fixdiaglab-design/esp32-obd-gauge/docs/hardware.md

# Апаратна частина

## Компоненти

| Компонент | Примітка |
|---|---|
| ESP32-C3 SuperMini | основна плата проєкту |
| Дисплей GC9A01 1.28" 240×240 | SPI, 7 пінів (VCC, GND, SCL, SDA, DC, CS, RST), без тачскріна й без виводу підсвітки |
| CAN-трансивер SN65HVD230 | 3.3 V. **Не** TJA1050/MCP2551: вони працюють від 5 V і не підходять до 3.3-вольтової логіки ESP32 |
| Штекер OBD-II з виводами | піни 4/5 (GND), 6 (CAN-H), 14 (CAN-L), 16 (+12 V) |
| MP1584EN | регульований понижувальний перетворювач, потрібен вихід 5.0 V |
| Запобіжник 1 А | у лінію +12 V |
| Макетна плата, дроти Dupont | |

## Розʼєм OBD-II

| Пін | Призначення |
|---|---|
| 4 | корпус (GND) |
| 5 | сигнальна земля (GND) |
| 6 | CAN-H |
| 14 | CAN-L |
| 16 | +12 V від акумулятора (постійне, навіть при вимкненому запалюванні). Для живлення приладу краще **не використовувати**, див. нижче |

## Живлення

Рекомендований варіант: **комутований +12 V через перехідник для запобіжника (fuse tap)**. Тоді з вимкненим запалюванням прилад не споживає нічого. На схемі [images/wiring.png](images/wiring.png) показано саме його.

1. **Налаштуйте buck до підключення плати.** Подайте на вхід 12 V, мультиметром на виході покрутіть підлаштовувальний резистор, поки не буде **5.0 V**. Лише потім зʼєднуйте вихід із пінами `5V` і `GND` ESP32-C3.
2. Візьміть **fuse tap** під ваш тип запобіжників і підключіть його до кола, яке вмикається із запалюванням і не є критичним для безпеки (не подушки, не ABS, не двигун). Яке саме, дивіться в схемі блоку запобіжників вашого авто. Запобіжник у перехіднику 1–2 А.
3. Мультиметром перевірте: без запалювання на цьому колі 0 V, із запалюванням близько 12 V.
4. +12 V від fuse tap подайте на вхід buck. **Пін 16 розʼєму OBD-II не підключайте**, інакше прилад живитиметься постійно в обхід запалювання.
5. GND беріть з піна 4 або 5 розʼєму OBD-II, CAN-H і CAN-L з пінів 6 і 14.
6. Поруч із входом buck рекомендовано поставити електролітичний конденсатор **470–1000 мкФ, 25 В**: при запуску двигуна напруга короткочасно просідає, і без нього плата може перезавантажитися.
7. **Під час прошивки через USB відключайте buck** від плати (щоб не було двох джерел живлення одночасно).

### Альтернатива: живлення від піна 16 OBD-II

Простіше, але прилад живиться завжди, навіть із вимкненим запалюванням. Лінія: пін 16 → запобіжник 1 А → вхід buck, GND з піна 4 або 5. Прилад споживає струм і на стоянці; підсвітка дисплея не вимикається навіть у режимі сну (у модуля з 7 пінами немає виводу керування підсвіткою). Споживання автор не вимірював. При тривалій стоянці відключайте прилад або додайте вимикач.

### Сон

Якщо авто не знайдено (немає відповіді на запити OBD) протягом `SLEEP_AFTER_MS` (за замовчуванням 15 хвилин), плата засинає в режимі deep sleep й прокидається, коли на CAN-шині з'являється трафік (лінія CRX, GPIO4). Кнопка BOOT (GPIO9) вивести плату зі сну не може: це обмеження ESP32-C3.

## Підключення

Дисплей GC9A01 (апаратний SPI):

| Дисплей | ESP32-C3 |
|---|---|
| SCL | GPIO6 |
| SDA | GPIO7 |
| CS | GPIO10 |
| DC | GPIO1 |
| RST | GPIO0 |
| VCC | 3V3 |
| GND | GND |

CAN-трансивер SN65HVD230:

| Трансивер | Куди |
|---|---|
| CTX | GPIO3 |
| CRX | GPIO4 |
| 3V3 | 3V3 |
| GND | GND |
| CANH | OBD-II пін 6 |
| CANL | OBD-II пін 14 |

Кнопка: вбудована кнопка **BOOT** (GPIO9). Не тримайте її натиснутою при подачі живлення: GPIO9 на ESP32-C3 вмикає режим завантаження.

Схема: [images/wiring.png](images/wiring.png).

> На платах із SN65HVD230 часто є запаяний резистор 120 Ом (термінатор). Шина авто вже має власні термінатори; вплив цього резистора в проєкті окремо не перевірявся.

## Варіант для ESP32 WROOM-32 DevKit

Якщо замість C3 використовується WROOM-32, змініть у скетчі визначення пінів:

| Сигнал | GPIO |
|---|---|
| TFT_SCK | 18 |
| TFT_MOSI | 23 |
| TFT_CS | 5 |
| TFT_DC | 16 |
| TFT_RST | 17 |
| CAN_TX | 22 |
| CAN_RX | 21 |
| BTN_PIN | 0 |

Живлення в цьому випадку подається на `VIN`, а не на `3V3`. Цей варіант в автора не перевірявся повністю на авто.

## CAN-шина

- Швидкість: 500 кбіт/с, а якщо авто не відповідає, 250 кбіт/с (перебір автоматичний).
- Адресація: 11-бітні ідентифікатори, запит `0x7DF`, відповіді `0x7E8–0x7EF`.
- Лише стандартні запити режиму 01. 29-бітні адреси й K-line не підтримуються.
