fixdiaglab-design/esp32-obd-gauge/firmware/assets/arc-segment-masks/arc_segments_27_240.png

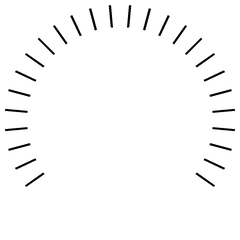
firmware/assets/arc-segment-masks/arc_segments_27_240.png
