fixdiaglab-design/esp32-obd-gauge/1,28TFT ESP32.stl

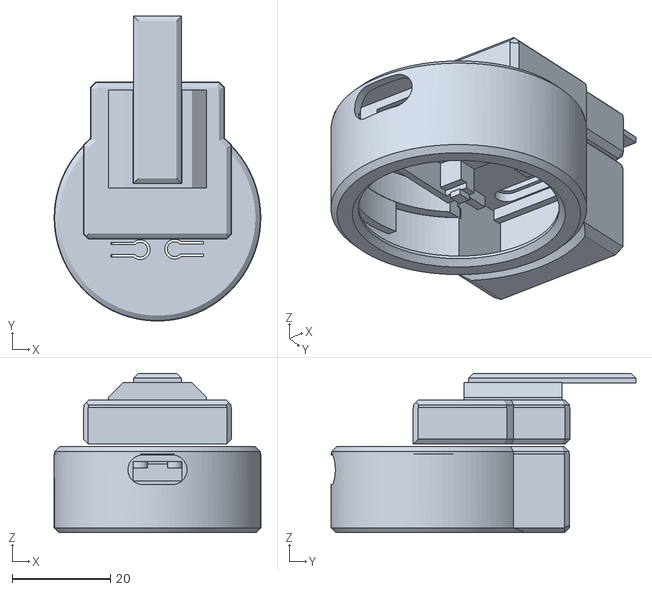
[picture p8: CAD file, 2026-10-26]
1,28TFT ESP32.stl
42.0 x 62.0 x 32.4
