fixdiaglab-design/esp32-obd-gauge/firmware/speedo_universalwifi/ui_font_Font1.c

/*******************************************************************************
 * Size: 26 px
 * Bpp: 1
 * Opts: --bpp 1 --size 26 --font D:/proect arduino/assets/RussoOne-Regular.ttf -o D:/proect arduino/assets\ui_font_Font1.c --format lvgl -r 0x20-0x7f --no-compress --no-prefilter
 ******************************************************************************/

#include "ui.h"

#ifndef UI_FONT_FONT1
#define UI_FONT_FONT1 1
#endif

#if UI_FONT_FONT1

/*-----------------
 *    BITMAPS
 *----------------*/

/*Store the image of the glyphs*/
static LV_ATTRIBUTE_LARGE_CONST const uint8_t glyph_bitmap[] = {
    /* U+0020 " " */
    0x0,

    /* U+0021 "!" */
    0xff, 0xff, 0xff, 0xff, 0xff, 0xff, 0xff, 0xf7,
    0x0, 0x1f, 0xff, 0xc0,

    /* U+0022 "\"" */
    0xf7, 0xfb, 0xfd, 0xfe, 0xff, 0x7f, 0xbc,

    /* U+0023 "#" */
    0x7, 0x8f, 0x1, 0xe3, 0xc0, 0x78, 0xf0, 0x1e,
    0x3c, 0x7f, 0xff, 0xdf, 0xff, 0xf7, 0xff, 0xfc,
    0x3c, 0x78, 0x1f, 0x1e, 0x7, 0x8f, 0x81, 0xe3,
    0xc3, 0xff, 0xfe, 0xff, 0xff, 0xbf, 0xff, 0xe3,
    0xc7, 0x80, 0xf1, 0xe0, 0x3c, 0x78, 0xf, 0x1e,
    0x0,

    /* U+0024 "$" */
    0x3, 0x80, 0x7, 0x0, 0xe, 0x1, 0xff, 0xc7,
    0xff, 0x9f, 0xff, 0x3e, 0x0, 0x7c, 0x0, 0xf8,
    0x1, 0xf0, 0x3, 0xff, 0xe3, 0xff, 0xe3, 0xff,
    0xe0, 0x7, 0xc0, 0xf, 0x80, 0x1f, 0x0, 0x3e,
    0x0, 0x7f, 0xff, 0xff, 0xff, 0xef, 0xff, 0x80,
    0x70, 0x0, 0xe0, 0x1, 0xc0,

    /* U+0025 "%" */
    0x7f, 0x3, 0x87, 0xfc, 0x3c, 0x38, 0xe1, 0xc1,
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
    0xc3, 0xf0, 0xf0, 0x7c, 0x1f, 0x7, 0xc1, 0xf0,
    0x7c, 0x1f, 0x7, 0xc1, 0xf3, 0xfc, 0xfe, 0x3f,
    0x0,

    /* U+007E "~" */
    0x3c, 0x3, 0xf1, 0xbf, 0xfe, 0xc7, 0xe0, 0x1e,
    0x0
};


/*---------------------
 *  GLYPH DESCRIPTION
 *--------------------*/

static const lv_font_fmt_txt_glyph_dsc_t glyph_dsc[] = {
    {.bitmap_index = 0, .adv_w = 0, .box_w = 0, .box_h = 0, .ofs_x = 0, .ofs_y = 0} /* id = 0 reserved */,
    {.bitmap_index = 0, .adv_w = 125, .box_w = 1, .box_h = 1, .ofs_x = 0, .ofs_y = 0},
    {.bitmap_index = 1, .adv_w = 116, .box_w = 5, .box_h = 18, .ofs_x = 1, .ofs_y = 0},
    {.bitmap_index = 13, .adv_w = 166, .box_w = 9, .box_h = 6, .ofs_x = 1, .ofs_y = 12},
    {.bitmap_index = 20, .adv_w = 304, .box_w = 18, .box_h = 18, .ofs_x = 1, .ofs_y = 0},
    {.bitmap_index = 61, .adv_w = 262, .box_w = 15, .box_h = 24, .ofs_x = 1, .ofs_y = -3},
    {.bitmap_index = 106, .adv_w = 358, .box_w = 21, .box_h = 18, .ofs_x = 1, .ofs_y = 0},
    {.bitmap_index = 154, .adv_w = 300, .box_w = 18, .box_h = 18, .ofs_x = 1, .ofs_y = 0},
    {.bitmap_index = 195, .adv_w = 87, .box_w = 4, .box_h = 6, .ofs_x = 1, .ofs_y = 12},
    {.bitmap_index = 198, .adv_w = 135, .box_w = 8, .box_h = 28, .ofs_x = 1, .ofs_y = -6},
    {.bitmap_index = 226, .adv_w = 135, .box_w = 8, .box_h = 28, .ofs_x = 0, .ofs_y = -6},
    {.bitmap_index = 254, .adv_w = 206, .box_w = 13, .box_h = 12, .ofs_x = 0, .ofs_y = 6},
    {.bitmap_index = 274, .adv_w = 225, .box_w = 12, .box_h = 12, .ofs_x = 1, .ofs_y = 3},
    {.bitmap_index = 292, .adv_w = 100, .box_w = 5, .box_h = 6, .ofs_x = 1, .ofs_y = -3},
    {.bitmap_index = 296, .adv_w = 196, .box_w = 11, .box_h = 3, .ofs_x = 1, .ofs_y = 7},
    {.bitmap_index = 301, .adv_w = 100, .box_w = 5, .box_h = 3, .ofs_x = 1, .ofs_y = 0},
    {.bitmap_index = 303, .adv_w = 196, .box_w = 12, .box_h = 18, .ofs_x = 0, .ofs_y = 0},
    {.bitmap_index = 330, .adv_w = 279, .box_w = 15, .box_h = 18, .ofs_x = 1, .ofs_y = 0},
    {.bitmap_index = 364, .adv_w = 168, .box_w = 9, .box_h = 18, .ofs_x = 0, .ofs_y = 0},
    {.bitmap_index = 385, .adv_w = 245, .box_w = 14, .box_h = 18, .ofs_x = 1, .ofs_y = 0},
    {.bitmap_index = 417, .adv_w = 254, .box_w = 15, .box_h = 18, .ofs_x = 0, .ofs_y = 0},
    {.bitmap_index = 451, .adv_w = 270, .box_w = 16, .box_h = 18, .ofs_x = 1, .ofs_y = 0},
    {.bitmap_index = 487, .adv_w = 250, .box_w = 15, .box_h = 18, .ofs_x = 1, .ofs_y = 0},
    {.bitmap_index = 521, .adv_w = 262, .box_w = 15, .box_h = 18, .ofs_x = 1, .ofs_y = 0},
    {.bitmap_index = 555, .adv_w = 233, .box_w = 14, .box_h = 18, .ofs_x = 1, .ofs_y = 0},
    {.bitmap_index = 587, .adv_w = 279, .box_w = 16, .box_h = 18, .ofs_x = 1, .ofs_y = 0},
    {.bitmap_index = 623, .adv_w = 262, .box_w = 15, .box_h = 18, .ofs_x = 1, .ofs_y = 0},
    {.bitmap_index = 657, .adv_w = 100, .box_w = 5, .box_h = 14, .ofs_x = 1, .ofs_y = 0},
    {.bitmap_index = 666, .adv_w = 100, .box_w = 5, .box_h = 17, .ofs_x = 1, .ofs_y = -3},
    {.bitmap_index = 677, .adv_w = 212, .box_w = 12, .box_h = 14, .ofs_x = 1, .ofs_y = 0},
    {.bitmap_index = 698, .adv_w = 204, .box_w = 11, .box_h = 8, .ofs_x = 1, .ofs_y = 6},
    {.bitmap_index = 709, .adv_w = 212, .box_w = 12, .box_h = 14, .ofs_x = 1, .ofs_y = 0},
    {.bitmap_index = 730, .adv_w = 241, .box_w = 15, .box_h = 18, .ofs_x = 0, .ofs_y = 0},
    {.bitmap_index = 764, .adv_w = 320, .box_w = 18, .box_h = 18, .ofs_x = 1, .ofs_y = 0},
    {.bitmap_index = 805, .adv_w = 295, .box_w = 19, .box_h = 18, .ofs_x = 0, .ofs_y = 0},
    {.bitmap_index = 848, .adv_w = 295, .box_w = 16, .box_h = 18, .ofs_x = 2, .ofs_y = 0},
    {.bitmap_index = 884, .adv_w = 258, .box_w = 15, .box_h = 18, .ofs_x = 1, .ofs_y = 0},
    {.bitmap_index = 918, .adv_w = 300, .box_w = 16, .box_h = 18, .ofs_x = 2, .ofs_y = 0},
    {.bitmap_index = 954, .adv_w = 264, .box_w = 15, .box_h = 18, .ofs_x = 2, .ofs_y = 0},
    {.bitmap_index = 988, .adv_w = 260, .box_w = 15, .box_h = 18, .ofs_x = 2, .ofs_y = 0},
    {.bitmap_index = 1022, .adv_w = 291, .box_w = 16, .box_h = 18, .ofs_x = 1, .ofs_y = 0},
    {.bitmap_index = 1058, .adv_w = 304, .box_w = 16, .box_h = 18, .ofs_x = 2, .ofs_y = 0},
    {.bitmap_index = 1094, .adv_w = 175, .box_w = 9, .box_h = 18, .ofs_x = 1, .ofs_y = 0},
    {.bitmap_index = 1115, .adv_w = 191, .box_w = 11, .box_h = 18, .ofs_x = 0, .ofs_y = 0},
    {.bitmap_index = 1140, .adv_w = 281, .box_w = 16, .box_h = 18, .ofs_x = 2, .ofs_y = 0},
    {.bitmap_index = 1176, .adv_w = 256, .box_w = 14, .box_h = 18, .ofs_x = 2, .ofs_y = 0},
    {.bitmap_index = 1208, .adv_w = 374, .box_w = 20, .box_h = 18, .ofs_x = 2, .ofs_y = 0},
    {.bitmap_index = 1253, .adv_w = 304, .box_w = 16, .box_h = 18, .ofs_x = 2, .ofs_y = 0},
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
    {.bitmap_index = 2631, .adv_w = 125, .box_w = 5, .box_h = 22, .ofs_x = 2, .ofs_y = -4},
    {.bitmap_index = 2645, .adv_w = 154, .box_w = 10, .box_h = 26, .ofs_x = 0, .ofs_y = -6},
    {.bitmap_index = 2678, .adv_w = 208, .box_w = 13, .box_h = 5, .ofs_x = 0, .ofs_y = 6}
};

/*---------------------
 *  CHARACTER MAPPING
 *--------------------*/



/*Collect the unicode lists and glyph_id offsets*/
static const lv_font_fmt_txt_cmap_t cmaps[] =
{
    {
        .range_start = 32, .range_length = 95, .glyph_id_start = 1,
        .unicode_list = NULL, .glyph_id_ofs_list = NULL, .list_length = 0, .type = LV_FONT_FMT_TXT_CMAP_FORMAT0_TINY
    }
};

/*-----------------
 *    KERNING
 *----------------*/


/*Pair left and right glyphs for kerning*/
static const uint8_t kern_pair_glyph_ids[] =
{
    3, 21,
    3, 34,
    8, 21,
    8, 34,
    11, 21,
    11, 34,
    14, 18,
    14, 19,
    14, 20,
    14, 24,
    14, 34,
    14, 43,
    14, 53,
    14, 55,
    14, 56,
    14, 58,
    14, 59,
    17, 24,
    19, 21,
    20, 20,
    20, 24,
    21, 3,
    21, 8,
    21, 11,
    21, 18,
    21, 19,
    21, 24,
    21, 63,
    21, 65,
    22, 18,
    22, 24,
    23, 18,
    23, 24,
    24, 13,
    24, 15,
    24, 21,
    25, 24,
    26, 24,
    34, 3,
    34, 8,
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
};

/* Kerning between the respective left and right glyphs
 * 4.4 format which needs to scaled with `kern_scale`*/
static const int8_t kern_pair_values[] =
{
    -17, -25, -17, -25, -17, -25, -17, -12,
    -12, -21, -12, -12, -25, -12, -8, -21,
    -17, -8, -17, -8, -8, -17, -17, -17,
    -21, 8, -25, -17, -17, -12, -8, -12,
    -8, -21, -21, -17, -8, -8, -25, -25,
    -25, -12, -8, -8, -8, -8, -29, -8,
    -29, -21, -33, -25, -25, -12, -8, -12,
    -8, -8, -8, -8, -8, -4, -12, -17,
    -17, -17, -12, -8, -8, -8, -8, -4,
    -33, -12, -33, -25, -21, -17, -17, -17,
    -17, -8, -17, -8, -8, -17, -8, -17,
    -17, -8, -8, -8, -17, -17, -17, -17,
    -17, -21, -17, -12, -17, -12, -12, -8,
    -8, -8, -8, -21, -21, -21, -17, -50,
    -42, -33, -50, -21, -21, -17, -17, -17,
    -8, -8, -1, -8, -8, -33, -33, -25,
    -1, -8, -8, -8, -8, -8, -8, -8,
    -21, -12, -12, -8, -12, -33, -25, -33,
    -29, -21, -21, -21, -21, -21, -12, -21,
    -21, -21, -21, -21, -21, -21, -21, -21,
    -21, -21, -21, -21, -21, -8, -33, -12,
    -33, -29, -8, -8, -21, -8, -8, -1,
    -17, -12, -12, -12, -12, -12, -12, -12,
    -12, -12, -12, -12, -12, -8, -21, -8,
    -21, -21, -8, -8, -17, -8, -8, -8,
    -8, -33, -21, -33, -33, -8, -8, -21,
    -8, -8, -1, -21, -21, -21, -21, -21,
    -12, -12, -21, -12, -21, -12, -21, -12,
    -12, -12, -12, -12, -12, -17, -17, -25,
    -17, -25, -4, -4, -4, -4, -4, -4,
    -4, -4, -4, -4, -4, -21, -21, -12,
    8, 17, -4, -4, -4, -4, -4, -4,
    -17, -8, -8, -17, -17, -17, -4, -4,
    -4, -4, -4, -4, -4, -4, -21, -21,
    -17, -8, -8, -8, -8, -8, -8, -8,
    -4, -8, -8, -8, -8, -8, -4, -4,
    -4, -8, -8, -8, -8, -8, -8, -8,
    -8, -8, -17, -17, -8, -4, -4, -4,
    -4, -4, -4, -12, -12, -8, -4, -4,
    -4, -4, -4, -4, -4, -4, -4, -4,
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
};

/*Collect the kern pair's data in one place*/
static const lv_font_fmt_txt_kern_pair_t kern_pairs =
{
    .glyph_ids = kern_pair_glyph_ids,
    .values = kern_pair_values,
    .pair_cnt = 331,
    .glyph_ids_size = 0
};

/*--------------------
 *  ALL CUSTOM DATA
 *--------------------*/

#if LVGL_VERSION_MAJOR == 8
/*Store all the custom data of the font*/
static  lv_font_fmt_txt_glyph_cache_t cache;
#endif

#if LVGL_VERSION_MAJOR >= 8
static const lv_font_fmt_txt_dsc_t font_dsc = {
#else
static lv_font_fmt_txt_dsc_t font_dsc = {
#endif
    .glyph_bitmap = glyph_bitmap,
    .glyph_dsc = glyph_dsc,
    .cmaps = cmaps,
    .kern_dsc = &kern_pairs,
    .kern_scale = 16,
    .cmap_num = 1,
    .bpp = 1,
    .kern_classes = 0,
    .bitmap_format = 0,
#if LVGL_VERSION_MAJOR == 8
    .cache = &cache
#endif
};



/*-----------------
 *  PUBLIC FONT
 *----------------*/

/*Initialize a public general font descriptor*/
#if LVGL_VERSION_MAJOR >= 8
const lv_font_t ui_font_Font1 = {
#else
lv_font_t ui_font_Font1 = {
#endif
    .get_glyph_dsc = lv_font_get_glyph_dsc_fmt_txt,    /*Function pointer to get glyph's data*/
    .get_glyph_bitmap = lv_font_get_bitmap_fmt_txt,    /*Function pointer to get glyph's bitmap*/
    .line_height = 28,          /*The maximum line height required by the font*/
    .base_line = 6,             /*Baseline measured from the bottom of the line*/
#if !(LVGL_VERSION_MAJOR == 6 && LVGL_VERSION_MINOR == 0)
    .subpx = LV_FONT_SUBPX_NONE,
#endif
#if LV_VERSION_CHECK(7, 4, 0) || LVGL_VERSION_MAJOR >= 8
    .underline_position = -2,
    .underline_thickness = 1,
#endif
    .dsc = &font_dsc,          /*The custom font data. Will be accessed by `get_glyph_bitmap/dsc` */
#if LV_VERSION_CHECK(8, 2, 0) || LVGL_VERSION_MAJOR >= 9
    .fallback = NULL,
#endif
    .user_data = NULL,
};



#endif /*#if UI_FONT_FONT1*/
