fixdiaglab-design/esp32-obd-gauge/firmware/speedo_universalwifi/ui_font_Font2.c

/*******************************************************************************
 * Size: 60 px
 * Bpp: 2
 * Opts: --bpp 2 --size 60 --font D:/proect arduino/spedo/assets/RussoOne-Regular.ttf -o D:/proect arduino/spedo/assets\ui_font_Font2.c --format lvgl -r 0x20-0x7f --no-compress --no-prefilter
 ******************************************************************************/

#include "ui.h"

#ifndef UI_FONT_FONT2
#define UI_FONT_FONT2 1
#endif

#if UI_FONT_FONT2

/*-----------------
 *    BITMAPS
 *----------------*/

/*Store the image of the glyphs*/
static LV_ATTRIBUTE_LARGE_CONST const uint8_t glyph_bitmap[] = {
    /* U+0020 " " */

    /* U+0021 "!" */
    0xff, 0xff, 0xff, 0xff, 0xff, 0xff, 0xff, 0xff,
    0xff, 0xff, 0xff, 0xff, 0xff, 0xff, 0xff, 0xff,
    0xff, 0xff, 0xff, 0xff, 0xff, 0xff, 0xff, 0xff,
    0xff, 0xff, 0xff, 0xff, 0xff, 0xff, 0xff, 0xff,
    0xff, 0xff, 0xff, 0xff, 0xff, 0xff, 0xff, 0xff,
    0xff, 0xff, 0xff, 0xff, 0xff, 0xff, 0xff, 0xff,
    0xff, 0xef, 0xff, 0xff, 0xbf, 0xff, 0xfe, 0xbf,
    0xff, 0xf6, 0xff, 0xff, 0xd7, 0xff, 0xff, 0x5f,
    0xff, 0xfc, 0x7f, 0xff, 0xf0, 0xff, 0xff, 0xc3,
    0xff, 0xff, 0xf, 0xff, 0xfc, 0x3f, 0xff, 0xe0,
    0x6a, 0xaa, 0x40, 0x0, 0x0, 0x0, 0x0, 0x0,
    0x0, 0x0, 0x3, 0xff, 0xff, 0xff, 0xff, 0xff,
    0xff, 0xff, 0xff, 0xff, 0xff, 0xff, 0xff, 0xff,
    0xff, 0xff, 0xff, 0xff, 0xff, 0xff, 0xff, 0xff,
    0xff, 0xff, 0xff, 0xf0,

    /* U+0022 "\"" */
    0x3f, 0xff, 0xf0, 0xff, 0xff, 0xc3, 0xff, 0xff,
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
    0x0, 0x7f, 0xff, 0xfc, 0x0, 0x7f, 0xff, 0xfc,
    0x0, 0x7f, 0xff, 0xfc, 0x0, 0x7f, 0xff, 0xfc,
    0x0, 0x7f, 0xff, 0xfc, 0x0, 0x7f, 0xff, 0xfc,
    0x0, 0x7f, 0xff, 0xfc, 0x0, 0x7f, 0xff, 0xfc,
    0x0, 0x7f, 0xff, 0xfc, 0x0, 0x7f, 0xff, 0xfc,
    0x0, 0x7f, 0xff, 0xfc,
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
